besi/kugelilift/Readme.md

Kugelilift
==========
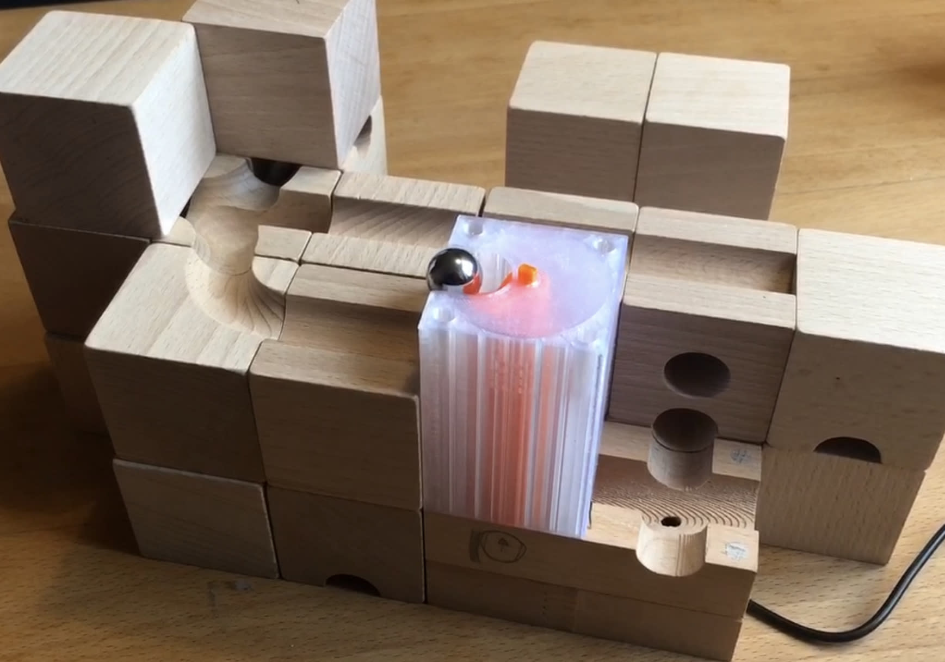
[picture p1: kugelilift.jpg]


Check out the sources:

    git submodule update --init --recursive
