besi/kugelilift/assets/base.dxf

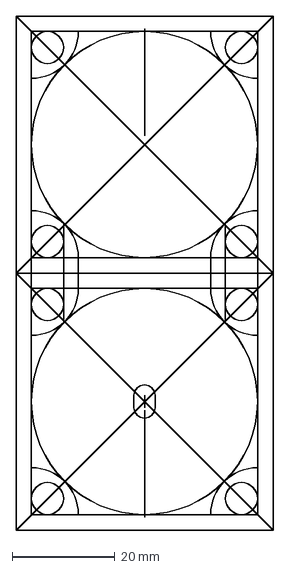
[picture p2: CAD file, 2023-12-22]
assets/base.dxf
50.0 x 100.0 mm
