besi/kugelilift/stl/Doubleshaft-3stories.stl

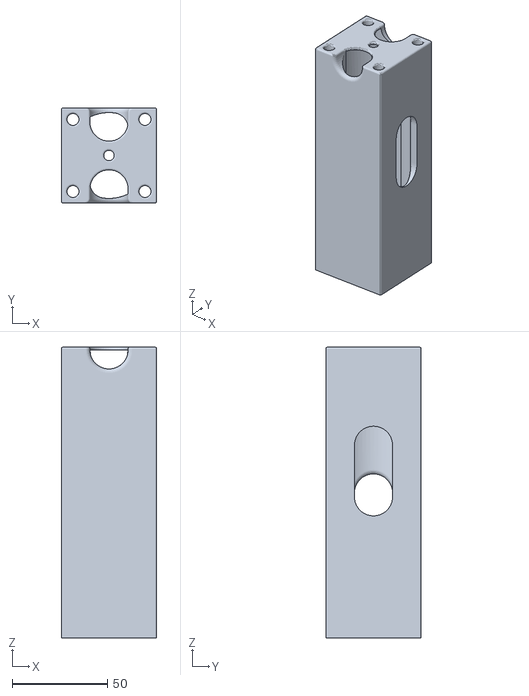
[picture p3: CAD file, 2024-02-07]
stl/Doubleshaft-3stories.stl
50.0 x 50.0 x 152.5
