besi/kugelilift/stl/Bottom.stl

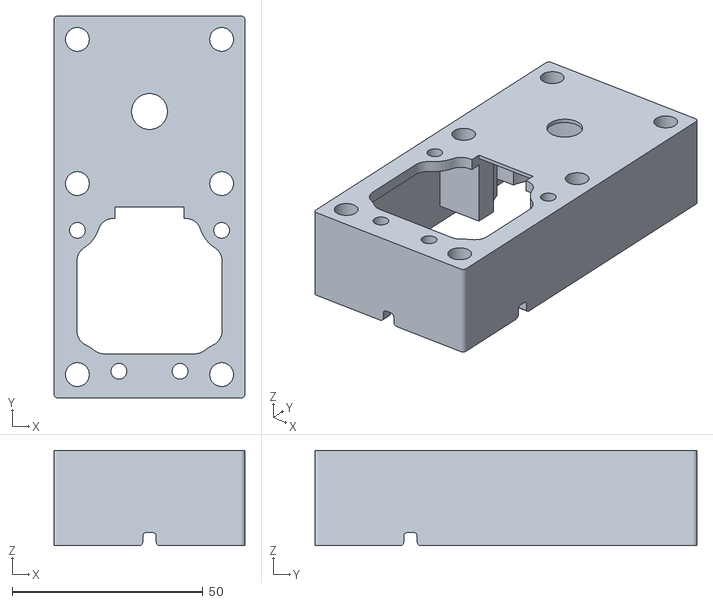
[picture p4: CAD file, 2024-02-07]
stl/Bottom.stl
50.0 x 100.0 x 25.0
