besi/kugelilift/stl/Top.stl

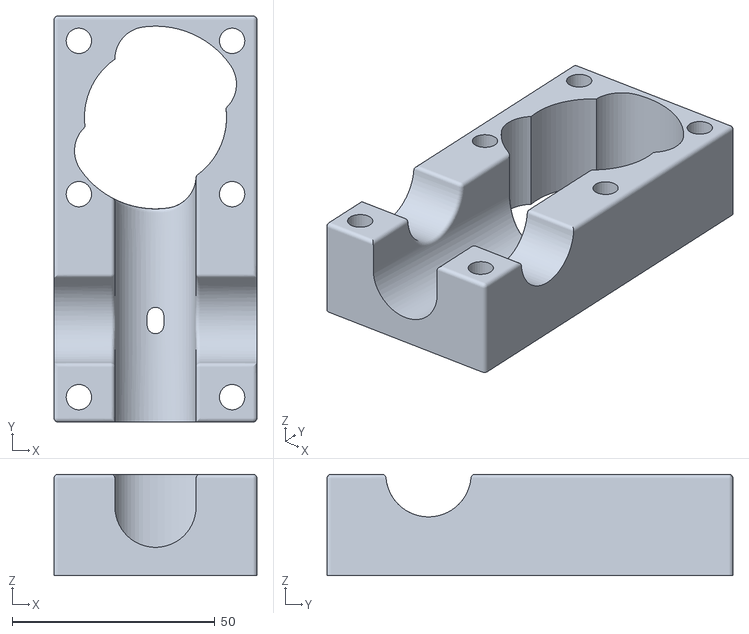
[picture p5: CAD file, 2024-02-07]
stl/Top.stl
50.0 x 100.0 x 25.0
