besi/kugelilift/stl/Conveyor-180-triple-3-5stories.stl

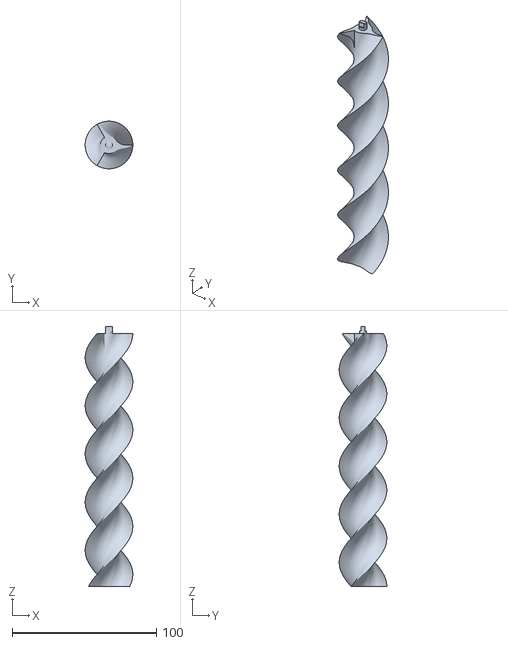
[picture p6: CAD file, 2024-02-07]
stl/Conveyor-180-triple-3-5stories.stl
33.0 x 33.0 x 180.0
