besi/kugelilift/stl/Conveyor-360.stl

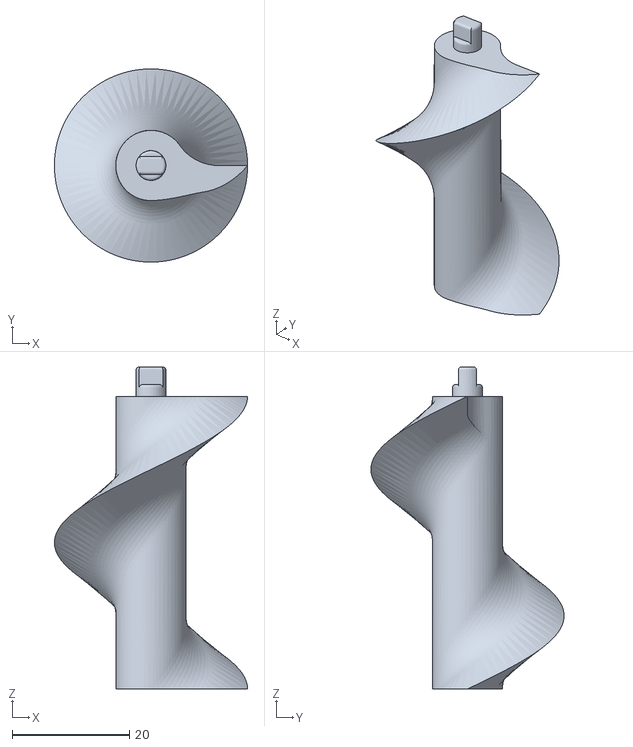
[picture p7: CAD file, 2024-01-21]
stl/Conveyor-360.stl
33.0 x 33.0 x 55.0
