besi/kugelilift/stl/Conveyor_180.stl

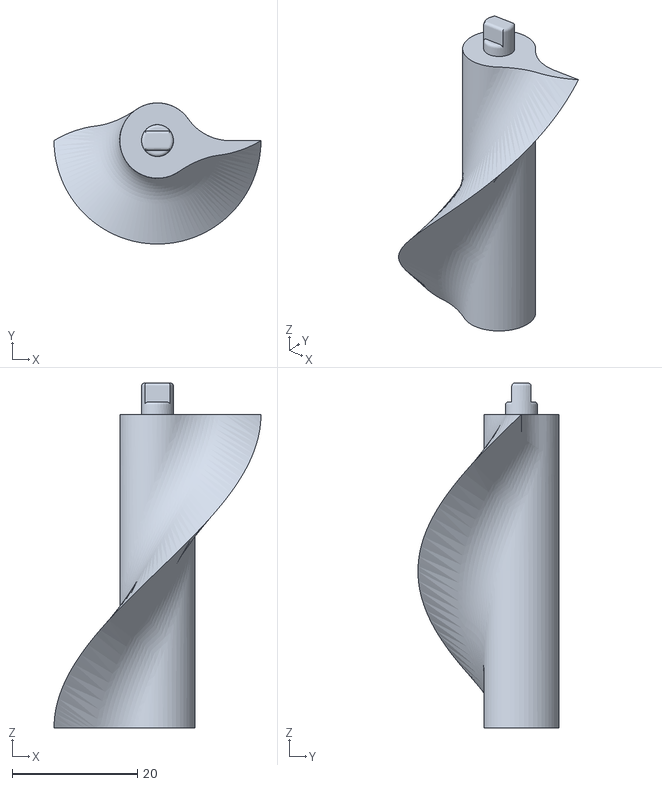
[picture p8: CAD file, 2024-01-21]
stl/Conveyor_180.stl
33.0 x 22.5 x 55.0
