besi/kugelilift/stl/Doubleshaft.stl

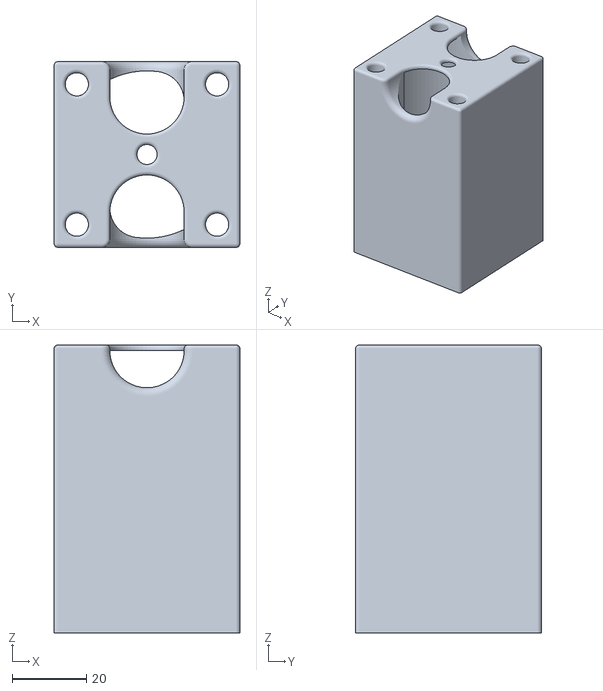
[picture p9: CAD file, 2024-01-21]
stl/Doubleshaft.stl
50.0 x 50.0 x 77.5
