besi/kugelilift/stl/Conveyor_180_triple.stl

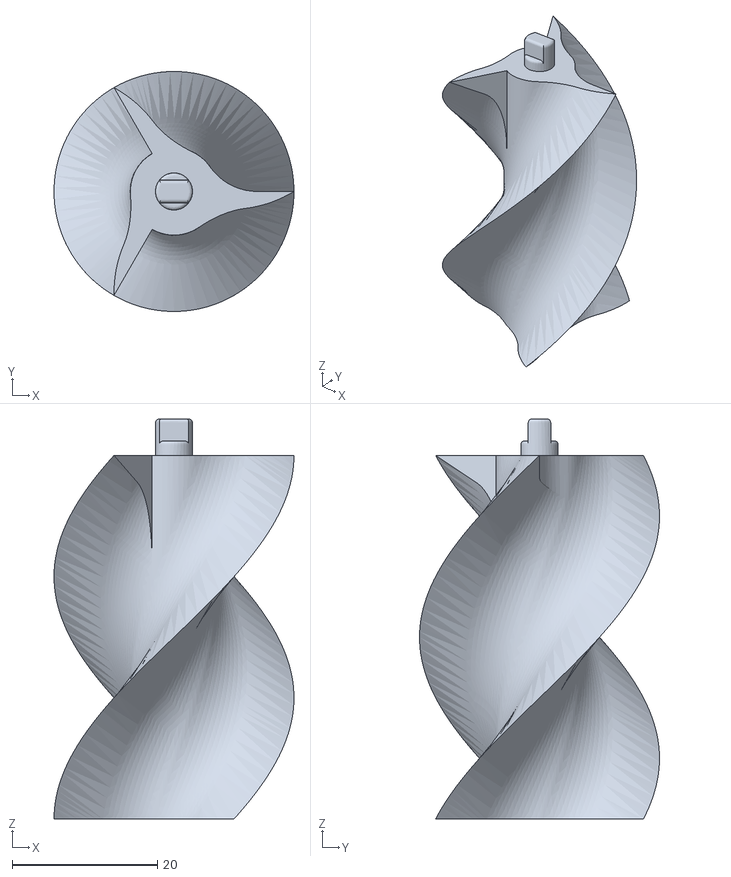
[picture p10: CAD file, 2024-01-21]
stl/Conveyor_180_triple.stl
33.0 x 33.0 x 55.0
