besi/kugelilift/Kugelilift.kicad_pcb

## KiCad design Kugelilift.kicad_pcb (2024-01-23)

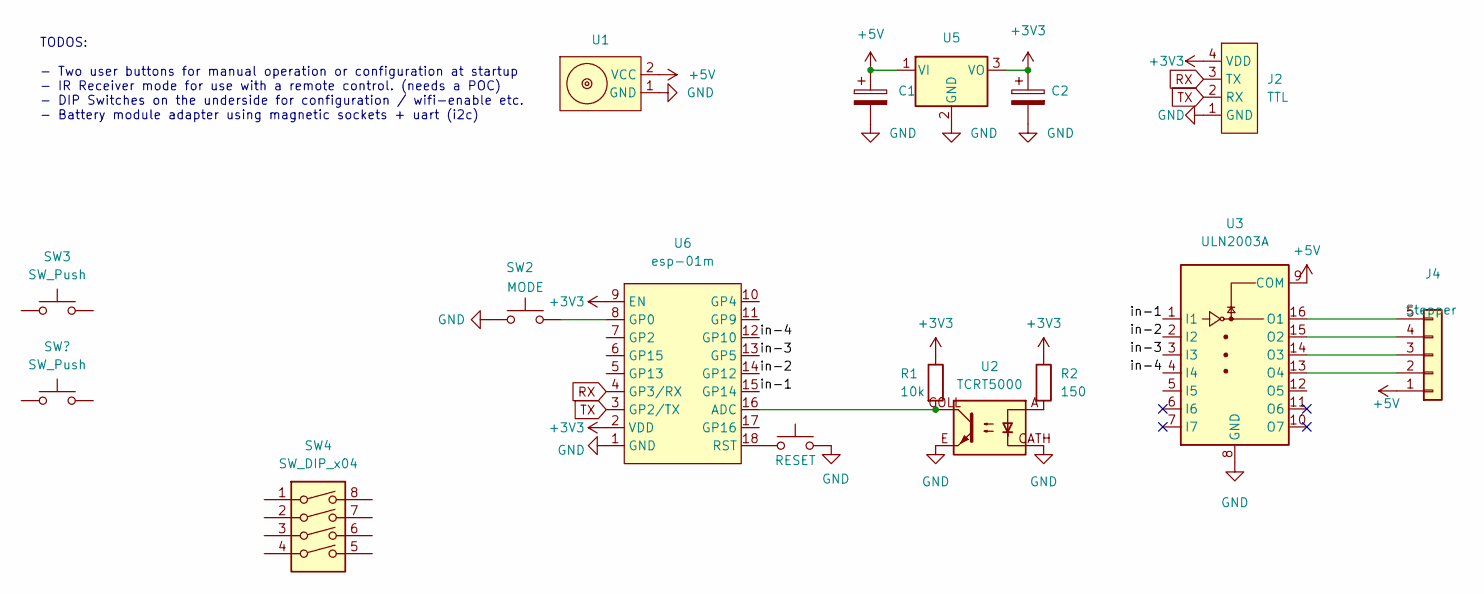
[picture p11: schematic Kugelilift.kicad_sch]

Parts:
C1, C2: C_Polarized; CP_Radial_D6.3mm_P2.50mm
J2: TTL; PinHeader_1x04_P2.54mm_Vertical
J4: Stepper; JST_EH_B5B-EH-A_1x05_P2.50mm_Vertical
R1: 10k; R_Axial_DIN0207_L6.3mm_D2.5mm_P10.16mm_Horizontal
R2: 150; R_Axial_DIN0207_L6.3mm_D2.5mm_P7.62mm_Horizontal
SW1: RESET; PinHeader_1x03_P2.54mm_Vertical
SW2: MODE; PinHeader_1x03_P2.54mm_Vertical
SW3: SW_Push; SW_Push_1P1T_NO_CK_KMR2
SW4: SW_DIP_x04; SW_DIP_SPSTx04_Slide_6.7x11.72mm_W7.62mm_P2.54mm_LowProfile
U1: magnetic-charger
U2: TCRT5000; tcrt5000
U3: ULN2003A; SOP-16_4.55x10.3mm_P1.27mm
U5: UA78M33_TO252; TO-252-2
U6: esp-01m

Connections:
+3V3: C2.1, J2.4 (VDD), R1.1, R2.1, U5.3 (VO), U6.2 (VDD), U6.9 (EN)
+5V: C1.1, J4.1, U1.2 (VCC), U3.9 (COM), U5.1 (VI)
/in-1: U3.1 (I1), U6.15 (GP14)
/in-2: U3.2 (I2), U6.14 (GP12)
/in-3: U3.3 (I3), U6.13 (GP5)
/in-4: U3.4 (I4), U6.12 (GP10)
GND: C1.2, C2.2, J2.1 (GND), SW1.2, SW2.2, U1.1 (GND), U2.CATH, U2.E, U3.8 (GND), U5.2 (GND), U6.1 (GND)
unnamed: J4.2, U3.13 (O4)
unnamed: J4.3, U3.14 (O3)
unnamed: J4.4, U3.15 (O2)
unnamed: J4.5, U3.16 (O1)
unnamed: R1.2, U2.COLL, U6.16 (ADC)
unnamed: R2.2, U2.A
unnamed: SW1.1, U6.18 (RST)
unnamed: SW2.1, U6.8 (GP0)
RX: J2.3 (TX), U6.4 (GP3/RX)
TX: J2.2 (RX), U6.3 (GP2/TX)

Notes on the sheet:
TODOS: - Two user buttons for manual operation or configuration at startup - IR Receiver mode for use with a remote control. (needs a POC) - DIP Switches on the underside for configuration / wifi-enable etc. - Battery module adapter using magnetic sockets + uart (i2c)

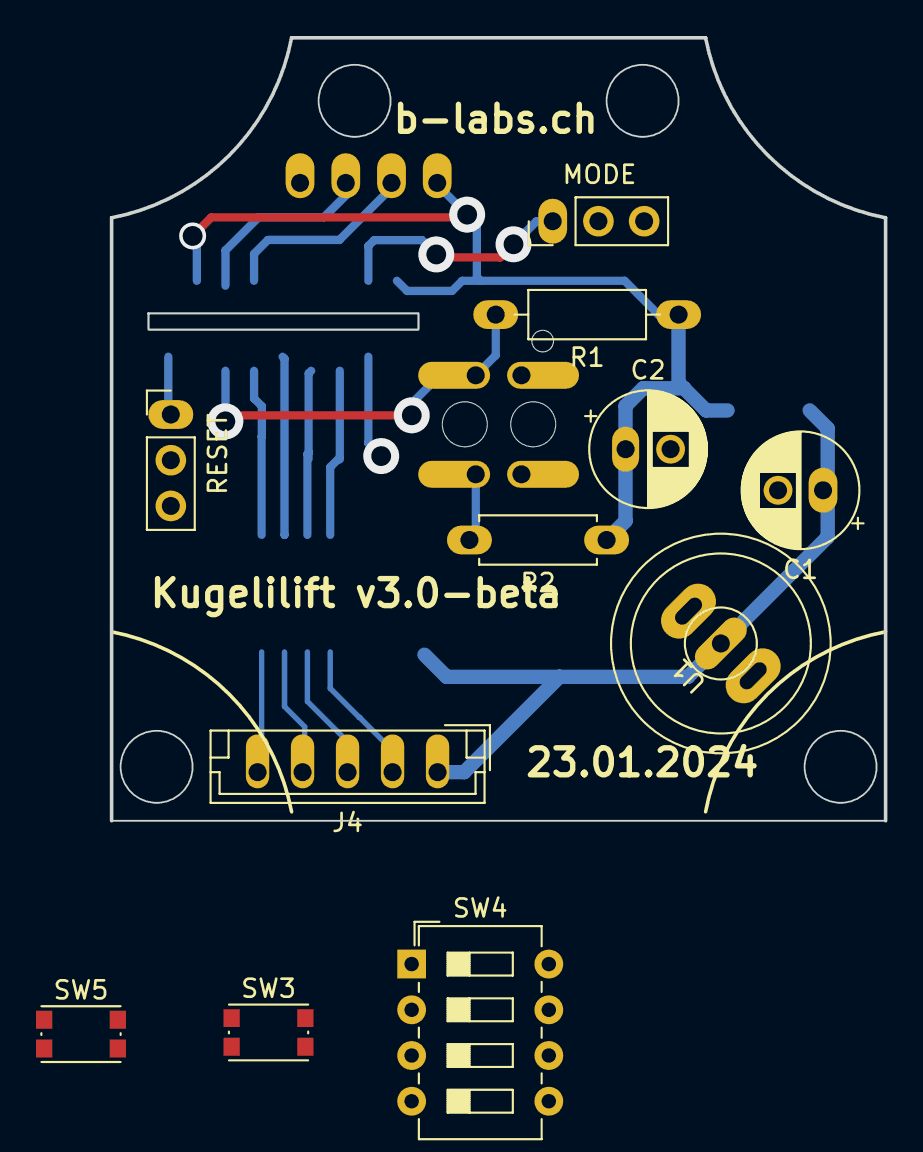
[picture p12: board Kugelilift.kicad_pcb from above]

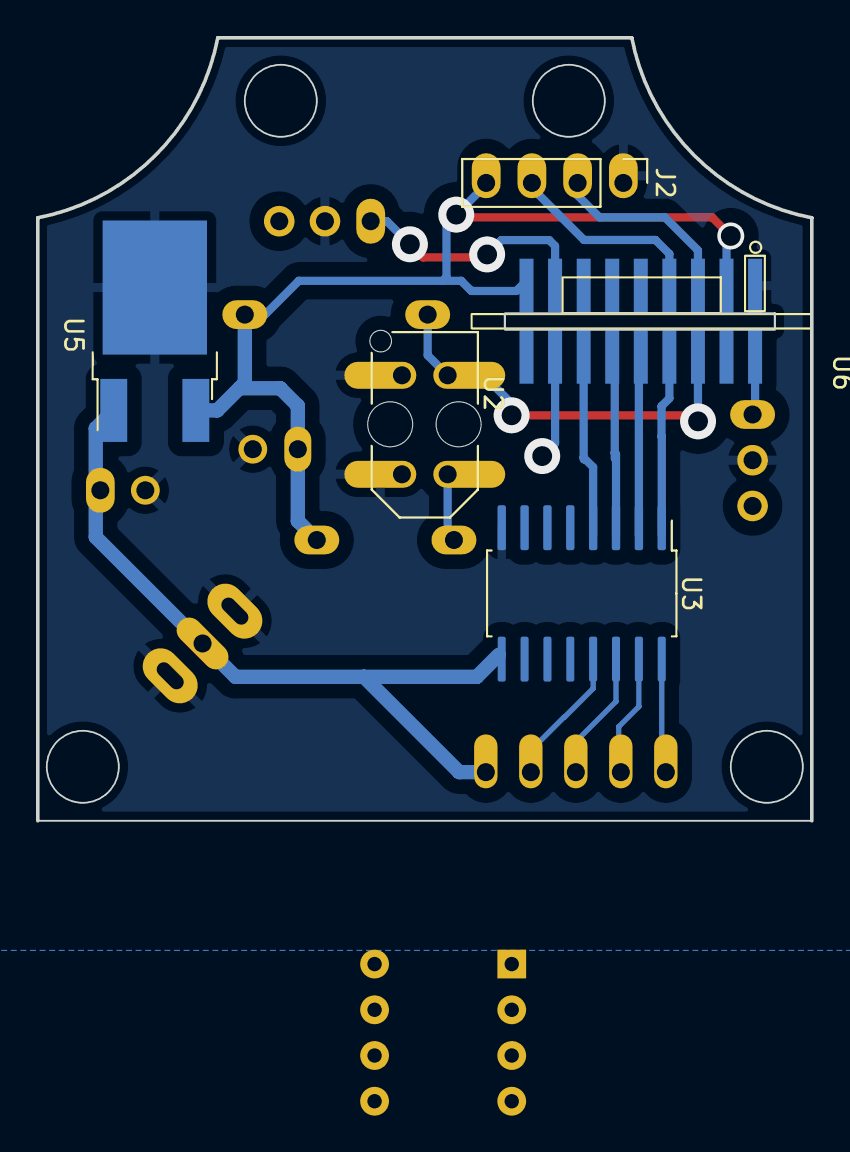
[picture p13: board Kugelilift.kicad_pcb from below]

Board: 2 copper layers, 43.0 x 43.5 mm, 16 parts (5 on the bottom side), 17 nets.

Other parts of the board:
SW5: SW_Push; SW_Push_1P1T_NO_CK_KMR2
