besi/kugelilift/(commit log)

2023-12-14 Initial commit of Kugelilift PCB
    [Kugelilift.kicad_pcb, Kugelilift.kicad_sch]
2023-12-14 Working progres with SMT ESP12 module
    [Kugelilift.kicad_pcb, Kugelilift.kicad_sch]
2023-12-14 ESP-01F based PCB
    [Kugelilift.kicad_pcb, Kugelilift.kicad_sch]
2023-12-15 PCB Version 2.2
    - ESP-12F
    - Linear regulator + Capacitors
    - ULN2003 in small SOP-16 package
    - TTL instead of USB
    - TCRT5000
    [Kugelilift.kicad_pcb, Kugelilift.kicad_sch]
2023-12-15 Prepare for milling
    [Kugelilift.kicad_pcb]
2023-12-15 Small adjustments for milling
    [Kugelilift.kicad_pcb]
2023-12-16 Add labels for header-buttons
    [Kugelilift.kicad_pcb]
2023-12-16 PCB based on ESP01m
    [Kugelilift.kicad_pcb, Kugelilift.kicad_sch]
2023-12-16 Export 3D File
    [Kugelilift.kicad_pcb]
2023-12-16 Small rearrangements
    [Kugelilift.kicad_pcb]
2023-12-18 Final adjustments
    [Kugelilift.kicad_pcb, Kugelilift.kicad_sch]
2023-12-22 Add correction factor for the stepper motor
2023-12-22 Add wifi capabilities
    [base.dxf]
2024-01-21 Add 3d models
    [Conveyor-360.stl, Conveyor_180.stl, Conveyor_180_triple.stl, Conveyor_steep.stl, Doubleshaft.stl]
2024-01-23 Prepare for next iteration
    [Kugelilift.kicad_pcb, Kugelilift.kicad_sch]
2024-01-23 Cleanup stls
    [Conveyor_steep.stl]
2024-02-01 Disable the WIFI since it’s not used mostly
    Opens #1
2024-02-01 Nod hello when switched on and adjust for tripple 180degree sprial
2024-02-07 3d print top and bottom
    [Bottom.stl, Conveyor-180-triple-3-5stories.stl, Doubleshaft-3stories.stl, Top.stl]
